Sparxx947/esphome-klingel/docs/verlauf.en.md

🇩🇪 [Deutsche Version](verlauf.md)

# Project history and decisions

| Date | Step | Result / decision |
|---|---|---|
| 04.10.2026 | Starting point | There was no doorbell entity in HA. First draft: **one** PC814 parallel to the chime via 1 kΩ 0.5 W on D5, event "Haustür" (front door); optional "chime mute" relay on D1 (normally closed, so the chime keeps ringing if the ESP fails). Compiled with ESPHome 2026.9.1: RAM 38.4 %, flash 40.2 %. |
| 04.10. evening | Jens: conventional system, **3 buttons**, no socket at the chime | 3 × PC814 on D5/D6/D7, one `event` each; power planned from the bell transformer (bridge rectifier + 1000 µF + step-down to 5.0 V). Recompiled: RAM 39.0 %, flash 40.3 %. |
| 04.10. late | Buttons = ground floor / floor 1 / floor 2; transformer in the stairwell distribution board | `substitutions` set; HA draft: 3 trigger templates for Alexa, automation `parallel`, lockout 15 s **per button** (tested). Two bugs of the first draft fixed (`not_from: unknown`, global lockout). Idea "everything at the transformer" with diode tap (2+2 anti-parallel 1N5408 in series with the return line, PC817/814 + ~47 Ω in parallel) – untested, since discarded. |
| 04.10. evening | paused | Jens: "remember it, we'll continue later". |
| 06.10. | Board inventory | Second D1 mini in stock → "D1 #2" for the doorbell, no new board needed. |
| 06.10. | Photos of distribution board | Plastic small distribution boards in a wooden recess (no metal → normal D1 mini). Transformer **Hager ST303, 8 VA**, 8 V (2–4) / 12 V (2–8). **Decision: do not power the D1 from the transformer** (8 VA for chime + ESP peaks ~350 mA too tight) → USB power supply at the distribution board socket. Next to it a Finder 14.01 (stair light, separate project). |
| 06.10. | Junction box | Jens: top left, **every** doorbell line runs through a junction box → tap point. Photos: doorbell wires only, the supposed paper is old masking-tape labelling. Assignment from photos not possible → measurement with multimeter. |
| 06.10. | Recipients | GF → residents ground floor, floor 1/2 → residents floors 1/2; wall panels for every floor. |
| 06.10. ~21:00 | Parts | PC814 not available on Amazon.de before 15.10. → **PC817C** + anti-parallel reverse diode (1N4007/1N5819 from the diode assortment). Series resistor 1 kΩ / 0.25 W. Perfboard: mini solder boards 45 × 39 mm. Both ordered by Jens. |
| 06.10. | Workshop book | Section K1 with schematic PC817 + 1N4007 (stripe to pin 1). |
| 07.10. | Delivery | PC817C and diode assortment arrived (confirmed by Jens on 08.10.). |
| 09.10. | Delivery | Mini solder boards arrived → parts complete (PC817C, diodes, boards). Wire measurement moved to Sat 10.10. |
| 10.10. (planned) | Measure wires | **Did not take place** – assignment of the wires in the junction box still open. |
| 11.10. | Firmware filter | Order corrected before the first flash: `delayed_off: 200ms` **first**, then `delayed_on: 230ms` (200 + 30 ms, because `delayed_off` also extends spikes by 200 ms). With PC817 + reverse diode the input at 50 Hz is ON for only ~10 ms per 20 ms – `delayed_on` first would have discarded every press. Header comments updated to PC817 + USB supply. |
| 11.10. | Colour schematic | Print sheet A4 landscape with wire colours: `plaene/klingel-schaltplan-farbig.pdf`. Doorbell side grey = chime return, yellow = ground floor, green = floor 1, blue = floor 2; ESP side yellow → D5, green → D6, blue → D7, black → G; no red (reserved for +5 V). |
| 11.10. | Enclosure | Designed in OpenSCAD (`gehaeuse/klingel-gehaeuse.scad`, parts `box`/`deckel`) and adapted to the measured dimensions (perfboard 44.12 × 38.74, D1 34.2 × 25.6, D1 height 25 mm, USB overmould 10.8 × 7.2, wires 4 × Ø 1.38). First version: openings ended blind because `hull()` with corner bosses on the outside thickened all walls to 6.5 mm → screw columns moved inside. Test print of an earlier version: perfboard fits. Printing of the current version not yet confirmed. |
| 11.10. | Board soldered | The mini solder board has **individual pads without tracks**. During the first soldering the connections reverse diode ↔ pin 1/pin 2, resistor ↔ pin 1 and pin 2 ↔ return conductor were therefore missing. After re-soldering, per channel (all 3 identical): diode test + on pin 1 → pin 2 = 1.08 V (LED), + on pin 2 → pin 1 = 0.60 V (1N4007); doorbell side ↔ ESP side no continuity. 1 kΩ resistors from stock fitted. |
| 11.10. | First flash | Locally via USB with the real secrets (ESPHome 2026.9.1): RAM 39.0 %, flash 40.3 %. Wi-Fi connected, API handshake with the real key ok. Created in the ESPHome Builder as `klingel.yaml`; Builder secrets, HA adoption and static IP open. |
| 11.10. | Bench test | An 18650 shield (power-bank board) as source gave **no** detection (presumably it does not switch its output on at ~8 mA load; not investigated further). With a bare 18650 cell (minus to grey, plus for 2–3 s to the colour) **passed**: blue → only "Etage 2", yellow → only "Erdgeschoss", green → only "Etage 1", several times each, event `gedrueckt` every time, no crosstalk. |
| 11.10. | Anomaly | In the `esphome logs` client the event `gedrueckt` arrived ~0.13–0.21 s **after** the OFF of the binary sensor each time, never at the ON (example: ON 44.26 s, OFF 49.84 s, event 50.05 s). Unexplained, check after HA adoption (see [troubleshooting no. 16](fehlersuche.en.md#16-event-appears-only-after-the-off)). |
| 11.10. | HA adoption | Builder secrets added, ESPHome integration adopted in HA (entities `event.klingel_erdgeschoss`/`_etage_1`/`_etage_2`, `binary_sensor.klingel_*_gedruckt`), static IP in the router. Event timing checked in HA: event 49.818 s before binary sensor ON 49.922 s (OFF 53.588 s) → the anomaly in the log client is **not a fault**. Enclosure printing. |
| 12.10. ~14:00 | Installation test PC817 | Board connected at the junction box (grey wire on the 5-way WAGO), chime rings normally. Practically nothing is detected: only sporadic hits (floor 1 and ground floor once each, floor 2 never), no permanent ON. Jens: the chime is a **battery chime**. The assumption "the transformer drives the chime" had **never been verified** until then. |
| 12.10. ~14:30–15:00 | Wrong measurement | First measurement series in the box: 0 V at rest, ~0.3 V when pressed; −0.6 V at rest. Conclusions were drawn from this ("reverse diode clamps the sensing circuit", then "0.6 V = sensing voltage of the chime"). **All these values were measured on DC**, AC was intended – meaningless on AC voltage. It only showed up in a cross-check **at a known reference**: transformer terminals 2–4 on AC = 8 V ✔. The conclusions drawn until then are void. Lesson: [einmessen.en.md 0](einmessen.en.md#0-check-meter-range-and-the-device-at-the-other-end-first), [fehlersuche.en.md no. 19](fehlersuche.en.md#19-readings-make-no-sense). |
| 12.10. ~15:00–16:35 | AC measurements, reconnecting | On AC: 5-way WAGO ↔ floor 1 wire 6.33 V at rest, 6.9 V when pressed (multimeter high-impedance); across the 1 kΩ 0 V when pressed → no current through the board. Grey wire successively on the 5-way WAGO, transformer terminals 2, 4 and 8 – several presses each, **0 hits**; the only hits were connection transients (several channels at once). Jens: the 5-way WAGO is transformer pole 4 (all button wires meet there) – so the WAGO and terminal-4 tests were the same. Against the WAGO the wire **rose** when pressed (7.7 → 8.3 V) instead of dropping to ~0 → the measured wire is not the one switched by the button. |
| 12.10. ~16:45 | **Cause found** | Photo of the floor 1 chime: electronic chime with a **9 V block battery**, loudspeaker, board, only 2 wires. DC at the chime terminals at rest **9 V**. → Each floor has its **own battery chime with a contact input**; the button only shorts the chime loop, the transformer is **not** in the chime circuit. The optocoupler therefore never gets current – that explains all failed attempts. Ground floor probably also 9 V (*unverified*), floor 2 a different chime with 3 × C cell = 4.5 V. Buttons without illumination. What the transformer is still used for is *unclear*. Grey wire disconnected, chimes work normally. |
| 12.10. ~17:05 | Plan 2N7000 | Print sheet `plaene/klingel-schaltplan-mosfet.pdf`: per floor plus wire → 1 MΩ → gate 2N7000, drain → D5/D6/D7 (internal pull-up), source + minus wires + G common; rest = LOW, press = HIGH. **Assumption (unmeasured):** separate plus wire per floor, minus sides can be joined. If floor 2 is below ~3.5 V, BC547 instead of 2N7000. |
| 12.10. ~17:15–17:40 | Parts | No MOSFETs/transistors in stock, but 1 MΩ available. Considered: a bag of 100 × 2N7000 and a resistor assortment; ordered instead: a **transistor set with 24 types** (contains 2N7000 and BC547 as fallback for floor 2), delivery 14.10. |
| 12.10. | Side finding | During the installation test an event arrived in HA, but `binary_sensor.klingel_*_gedruckt` never showed "on". **Unexplained.** |
| 13.10. | Cross-check and docs | Firmware local = ESPHome Builder (checked) = `firmware/klingel.yaml` in the repo (except the deliberately removed MAC address). **Firmware not yet switched to 2N7000.** Repo updated: status, MOSFET plan and measuring sheet in `plaene/`, measurement lesson in einmessen/fehlersuche. Open: measure polarity per floor, rebuild from 14.10. |
| 14.10. | DC measurement | Only DC at the chime; when ringing it drops to **0 V** at the chime → contact input confirmed (the button shorts the battery loop). Per floor: terminal 1 = chime wire, terminal 2 = return. Floor 1 ~9.5 V, ground floor **2 × AA ≈ 3 V** (2.7 V in the box), floor 2 initially without batteries (silent, fitted with 3 × C cells on 15.10.). |
| 14.10. | 2N7000 dropped | For the ground floor with ~3 V the 2N7000 gate threshold is too marginal → **BC517** (Darlington) ordered, base resistor 10 MΩ. |
| 16.10. | New board layout | Working area 13 × 13 holes centred on the mini board (enclosure still fits), TO-92 rotated. Two variants from one script: 3 × BC517 + 10 MΩ and a substitute 3 × (2 × BC547 as Darlington) + 1 MΩ in case the delivery fails (`plaene/klingel_darlington_layout.py`). |
| 17.10. | Delivery delay | 10 MΩ sold out → switched to **9.1 MΩ**; fits without layout change (calculated: ground floor ~0.2 µA base current, loop stays at ~2.8 V). |
| 20.10. | Delivery + rebuild | BC517 and 9.1 MΩ arrived, plan changed to 9.1 MΩ (colour bands white–brown–blue). Board rebuilt and connected. |
| 20.10. ~15:15 | First test ✗ | All three channels HIGH at idle, no event for 9 presses (with the old, inverted firmware "idle LOW" would have shown as permanently "pressed"). Once the ground-floor chime rang an extra time (unexplained). |
| 20.10. ~15:30–15:55 | Troubleshooting | Measuring sheet (`plaene/klingel-messblatt-bc517.pdf`): reference 3V3↔G = +3.3 V; Kl.1 against grey **+3.1 / +9.47 / +5.5 V** (polarity correct). "G against wire" however gave −2 / −2 / −4 V – this was wrongly taken as a missing GND connection; the continuity check (`plaene/klingel-durchgang-bc517.pdf`) showed all GND connections fine. Where the −2/−4 V came from is **unexplained**. |
| 20.10. 16:03 | Working | After a further fix on the board (details not recorded) all three channels are correct at idle (LOW); test presses on floors 1/2 detected. |
| 20.10. 16:13 | Firmware BC517 | Via OTA from the ESPHome Builder: `inverted: false`, `delayed_on: 30ms` / `delayed_off: 100ms`, new sensor "Klingelbatterie leer" (one channel pressed > 30 s). |
| 20.10. 16:17 | **Acceptance passed** | Ground floor, floor 1, floor 2 in turn → exactly one event each (pressed 0.31 / 0.37 / 0.34 s), no crosstalk. The event arrives ~0.1 s before the binary sensor – the side finding of 12.10. is resolved. |
| 20.10. ~15:15 | No crosstalk | An extra ring on the ground floor right after the first test presses was a real visitor at the front door. |
| 20.10. 17:03 | **HA integration accepted** | Push with camera image to the phone; ground floor and floor 1 show the live image on their wall panel for 90 s and return to the start page ([home-assistant.en.md](home-assistant.en.md)). |

## Discarded variants

| Variant | Reason |
|---|---|
| Power from the bell transformer (rectifier, electrolytic capacitor, step-down) | Hager ST303 has only 8 VA; socket available in the distribution board |
| Tap directly at the transformer via diodes in the return line | junction box offers all floors in one place, without intervening in the distribution board |
| DIN-rail enclosure in the distribution board | tap no longer in the distribution board |
| D1 mini Pro with external antenna | no metal cabinet; only if RSSI at the installation site is poor |
| PC814 | not available at short notice |
| Powering the bench test via an 18650 shield (power-bank board) | no detection (load cut-off suspected) → bare cell or lab power supply |
| Bench test with 5 V from the D1 mini (suggestion from `einmessen.md`) | G on the D1 is occupied, isolation doorbell/ESP side would not be preserved → separate battery |
| **Optocoupler tap (PC817 + 1N4007 + 1 kΩ)** | 12.10.: the chimes are battery chimes with a contact input, the transformer is not in the chime circuit → the LED never gets current. Replacement: BC517 + 9.1 MΩ (since 20.10.) |
| 2N7000 + 1 MΩ | 14.10.: ground-floor loop only ~3 V, gate threshold too marginal → BC517 |
| ESP between button and chime (trigger the chime via PC817) or ESP32 ADC with bias divider | briefly considered on 12.10. – based on the wrong DC measurement, therefore void |
