Sparxx947/esphome-klingel/docs/verlauf.md

🇬🇧 [English version](verlauf.en.md)

# Projektverlauf und Entscheidungen

| Datum | Schritt | Ergebnis / Entscheidung |
|---|---|---|
| 04.10.2026 | Ausgangslage | In HA gab es keine Klingel-Entität. Erster Entwurf: **ein** PC814 parallel zum Gong über 1 kΩ 0,5 W an D5, Event „Haustür“; optional Relais „Gong stumm“ an D1 (Öffner, damit der Gong bei ESP-Ausfall weiter klingelt). Kompiliert mit ESPHome 2026.9.1: RAM 38,4 %, Flash 40,2 %. |
| 04.10. abends | Jens: klassische Anlage, **3 Taster**, keine Steckdose am Gong | 3 × PC814 an D5/D6/D7, je ein `event`; Versorgung aus dem Klingeltrafo geplant (Brückengleichrichter + 1000 µF + Step-down auf 5,0 V). Neu kompiliert: RAM 39,0 %, Flash 40,3 %. |
| 04.10. spät | Taster = Erdgeschoss / Etage 1 / Etage 2; Trafo im Verteiler Treppenhaus | `substitutions` gesetzt; HA-Entwurf: 3 Trigger-Templates für Alexa, Automation `parallel`, Sperre 15 s **je Taster** (getestet). Zwei Fehler des ersten Entwurfs behoben (`not_from: unknown`, globale Sperre). Idee „alles am Trafo“ mit Dioden-Abgriff (2+2 antiparallele 1N5408 in Reihe zur Rückleitung, PC817/814 + ~47 Ω parallel) – ungetestet, inzwischen verworfen. |
| 04.10. abends | pausiert | Jens: „merken, machen wir später weiter“. |
| 06.10. | Board-Inventur | Zweiter D1 mini im Bestand → „D1 #2“ für die Klingel, kein neues Board nötig. |
| 06.10. | Fotos Verteiler | Kunststoff-Kleinverteiler in Holznische (kein Metall → normaler D1 mini). Trafo **Hager ST303, 8 VA**, 8 V (2–4) / 12 V (2–8). **Entscheidung: D1 nicht aus dem Trafo versorgen** (8 VA für Gong + ESP-Spitzen ~350 mA zu knapp) → USB-Netzteil an der Verteiler-Steckdose. Daneben Finder 14.01 (Treppenlicht, eigenes Projekt). |
| 06.10. | Abzweigdose | Jens: oben links läuft **jede** Klingelleitung durch eine Abzweigdose → Abgriffpunkt. Fotos: nur Klingeladern, das vermeintliche Papier ist alte Kreppband-Beschriftung. Zuordnung aus Fotos nicht möglich → Messung mit Multimeter. |
| 06.10. | Empfänger | EG → Bewohner EG, Etage 1/2 → Bewohner Etage 1/2; Wandpanels bei jeder Etage. |
| 06.10. ~21:00 | Teile | PC814 bei Amazon.de nicht vor 15.10. lieferbar → **PC817C** + antiparallele Gegendiode (1N4007/1N5819 aus dem Diodensortiment). Vorwiderstand 1 kΩ / 0,25 W. Lochraster: Minilötplatinen 45 × 39 mm. Beides von Jens bestellt. |
| 06.10. | Werkstattbuch | Abschnitt K1 mit Schaltplan PC817 + 1N4007 (Strich an Pin 1). |
| 07.10. | Lieferung | PC817C und Diodensortiment da (von Jens am 08.10. bestätigt). |
| 09.10. | Lieferung | Minilötplatinen da → Teile komplett (PC817C, Dioden, Platinen). Adern-Messung auf Sa 10.10. verschoben. |
| 10.10. (geplant) | Adern messen | **Hat nicht stattgefunden** – Zuordnung der Adern in der Abzweigdose weiter offen. |
| 11.10. | Firmware-Filter | Reihenfolge vor dem Erstflash korrigiert: `delayed_off: 200ms` **zuerst**, dann `delayed_on: 230ms` (200 + 30 ms, weil `delayed_off` auch Störspitzen um 200 ms verlängert). Mit PC817 + Gegendiode ist der Eingang bei 50 Hz nur ~10 ms je 20 ms EIN – `delayed_on` zuerst hätte jeden Druck verworfen. Kopfkommentare auf PC817 + USB-Versorgung aktualisiert. |
| 11.10. | Schaltplan farbig | Druckblatt A4 quer mit Litzenfarben: `plaene/klingel-schaltplan-farbig.pdf`. Klingelseite grau = Gong-Rückleiter, gelb = Erdgeschoss, grün = Etage 1, blau = Etage 2; ESP-Seite gelb → D5, grün → D6, blau → D7, schwarz → G; kein Rot (bleibt für +5 V). |
| 11.10. | Gehäuse | In OpenSCAD konstruiert (`gehaeuse/klingel-gehaeuse.scad`, Teile `box`/`deckel`) und auf die gemessenen Maße angepasst (Lochraster 44,12 × 38,74, D1 34,2 × 25,6, Bauhöhe D1 25 mm, USB-Umspritzung 10,8 × 7,2, Litzen 4 × Ø 1,38). Erste Fassung: Durchbrüche endeten blind, weil `hull()` mit außen liegenden Eckdomen alle Wände auf 6,5 mm verdickte → Schraubsäulen nach innen. Testdruck einer früheren Fassung: Lochraster passt. Druck der aktuellen Fassung noch nicht bestätigt. |
| 11.10. | Platine gelötet | Die Minilötplatine hat **einzelne Lötpunkte ohne Leiterbahnen**. Beim ersten Löten fehlten deshalb die Verbindungen Gegendiode ↔ Pin 1/Pin 2, Widerstand ↔ Pin 1 und Pin 2 ↔ Rückleiter. Nach dem Nachlöten je Kanal (alle 3 gleich): Diodentest + an Pin 1 → Pin 2 = 1,08 V (LED), + an Pin 2 → Pin 1 = 0,60 V (1N4007); Klingelseite ↔ ESP-Seite kein Durchgang. 1 kΩ-Widerstände aus dem Bestand verbaut. |
| 11.10. | Erstflash | Per USB lokal mit echten Secrets (ESPHome 2026.9.1): RAM 39,0 %, Flash 40,3 %. WLAN verbunden, API-Handshake mit echtem Schlüssel ok. Im ESPHome Builder als `klingel.yaml` angelegt; Builder-Secrets, HA-Adoption und feste IP offen. |
| 11.10. | Tischtest | Ein 18650-Shield (Powerbank-Platine) als Quelle lieferte **keine** Erkennung (vermutlich schaltet es bei ~8 mA Last den Ausgang nicht ein, nicht weiter untersucht). Mit einer nackten 18650-Zelle (Minus an grau, Plus 2–3 s an die Farbe) **bestanden**: blau → nur „Etage 2“, gelb → nur „Erdgeschoss“, grün → nur „Etage 1“, je mehrfach, jedes Mal Event `gedrueckt`, kein Übersprechen. |
| 11.10. | Auffälligkeit | Im `esphome logs`-Client kam das Event `gedrueckt` jeweils ~0,13–0,21 s **nach** dem OFF des Binärsensors an, nie beim ON (Beispiel: ON 44,26 s, OFF 49,84 s, Event 50,05 s). Ungeklärt, nach der HA-Adoption prüfen (siehe [Fehlersuche Nr. 16](fehlersuche.md#16-event-erscheint-erst-nach-dem-off)). |
| 11.10. | HA-Adoption | Builder-Secrets eingetragen, ESPHome-Integration in HA eingebunden (Entitäten `event.klingel_erdgeschoss`/`_etage_1`/`_etage_2`, `binary_sensor.klingel_*_gedruckt`), feste IP im Router. Event-Zeitpunkt in HA geprüft: Event 49,818 s vor Binärsensor-EIN 49,922 s (AUS 53,588 s) → die Auffälligkeit im Log-Client ist **kein Fehler**. Gehäuse im Druck. |
| 12.10. ~14:00 | Einbautest PC817 | Platine an der Abzweigdose angeschlossen (graue Litze an die 5er-WAGO), Gong läutet normal. Erkannt wird praktisch nichts: nur sporadische Treffer (Etage 1 und Erdgeschoss je einmal, Etage 2 nie), kein Dauer-EIN. Jens: der Gong ist ein **Batteriegong**. Die Annahme „der Trafo treibt den Gong“ war bis dahin **nie geprüft** worden. |
| 12.10. ~14:30–15:00 | Fehlmessung | Erste Messreihe in der Dose: Ruhe 0 V, beim Drücken ~0,3 V; in Ruhe −0,6 V. Daraus zunächst Schlüsse gezogen („Gegendiode klemmt den Abfragekreis“, dann „0,6 V = Abfragespannung des Gongs“). **Alle diese Werte waren auf DC gemessen**, gemeint war AC – an Wechselspannung bedeutungslos. Aufgefallen ist es erst beim Gegencheck **am bekannten Anker**: Trafo Klemme 2–4 auf AC = 8 V ✔. Die bis dahin gezogenen Schlüsse sind damit hinfällig. Lehre: [einmessen.md 0](einmessen.md#0-messbereich-und-gerät-am-anderen-ende-zuerst-prüfen), [fehlersuche.md Nr. 19](fehlersuche.md#19-messwerte-ergeben-keinen-sinn). |
| 12.10. ~15:00–16:35 | AC-Messungen, Umklemmen | Auf AC: 5er-WAGO ↔ Ader Etage 1 in Ruhe 6,33 V, beim Drücken 6,9 V (Multimeter hochohmig); über dem 1 kΩ beim Drücken 0 V → kein Strom durch die Platine. Graue Litze nacheinander an 5er-WAGO, Trafo-Klemme 2, 4 und 8 – je mehrere Drücke, **0 Treffer**; die einzigen Treffer waren Anklemmstöße (mehrere Kanäle gleichzeitig). Jens: die 5er-WAGO ist Trafo-Pol 4 (alle Taster-Leitungen laufen dort zusammen) – WAGO- und Klemme-4-Test waren also derselbe. Gegen die WAGO **stieg** die Ader beim Drücken (7,7 → 8,3 V) statt auf ~0 zu fallen → die gemessene Ader ist nicht die vom Taster geschaltete. |
| 12.10. ~16:45 | **Ursache gefunden** | Foto des Gongs Etage 1: elektronischer Gong mit **9-V-Block**, Lautsprecher, Platine, nur 2 Drähte. DC an den Gong-Klemmen in Ruhe **9 V**. → Jede Etage hat einen **eigenen Batteriegong mit Kontakteingang**; der Taster schließt nur die Gong-Schleife kurz, der Trafo ist **nicht** im Gong-Kreis. Der Optokoppler bekommt deshalb nie Strom – das erklärt alle Fehlversuche. Erdgeschoss vermutlich auch 9 V (*ungeprüft*), Etage 2 ein anderer Gong mit 3 × Babyzelle = 4,5 V. Taster ohne Beleuchtung. Wozu der Trafo noch dient, ist *ungeklärt*. Graue Litze abgeklemmt, Gongs laufen normal. |
| 12.10. ~17:05 | Plan 2N7000 | Druckblatt `plaene/klingel-schaltplan-mosfet.pdf`: je Etage Plus-Ader → 1 MΩ → Gate 2N7000, Drain → D5/D6/D7 (interner Pull-up), Source + Minus-Adern + G gemeinsam; Ruhe = LOW, Druck = HIGH. **Annahme (ungemessen):** je Etage eigene Plus-Ader, Minus-Seiten verbindbar. Liegt Etage 2 unter ~3,5 V, BC547 statt 2N7000. |
| 12.10. ~17:15–17:40 | Teile | Keine MOSFETs/Transistoren im Bestand, 1 MΩ aber vorhanden. Erwogen: 2N7000 im 100er-Beutel und ein Widerstandssortiment; bestellt wurde stattdessen ein **Transistor-Set mit 24 Typen** (enthält 2N7000 und BC547 als Ausweichlösung für Etage 2), Lieferung 14.10. |
| 12.10. | Nebenbefund | Beim Einbautest kam ein Event in HA an, `binary_sensor.klingel_*_gedruckt` zeigte dabei nie „on“. **Ungeklärt.** |
| 13.10. | Abgleich und Doku | Firmware lokal = ESPHome Builder (geprüft) = `firmware/klingel.yaml` im Repo (bis auf die bewusst entfernte MAC-Adresse). **Firmware noch nicht auf 2N7000 umgestellt.** Repo nachgezogen: Status, MOSFET-Plan und Messblatt in `plaene/`, Mess-Lehre in einmessen/fehlersuche. Offen: Polarität je Etage messen, Umbau ab 14.10. |
| 14.10. | DC-Messung | Am Gong nur Gleichspannung; beim Klingeln fällt sie am Gong auf **0 V** → Kontakteingang bestätigt (Taster schließt die Batterie-Schleife kurz). Je Etage: Klemme 1 = Gong-Ader, Klemme 2 = Rückkanal. Etage 1 ~9,5 V, Erdgeschoss **2 × AA ≈ 3 V** (2,7 V in der Dose), Etage 2 zunächst ohne Batterien (stumm, am 15.10. mit 3 × Babyzelle bestückt). |
| 14.10. | 2N7000 verworfen | Für das Erdgeschoss mit ~3 V ist die Gate-Schwelle des 2N7000 zu knapp → **BC517** (Darlington) bestellt, Basiswiderstand 10 MΩ. |
| 16.10. | Neues Platinenlayout | Arbeitsfeld 13 × 13 Löcher mittig auf der Minilötplatine (Gehäuse passt weiter), TO-92 gedreht. Zwei Varianten aus einem Skript: 3 × BC517 + 10 MΩ und Ersatz 3 × (2 × BC547 als Darlington) + 1 MΩ für den Fall, dass die Lieferung ausbleibt (`plaene/klingel_darlington_layout.py`). |
| 17.10. | Lieferverzug | 10 MΩ ausverkauft → Tausch auf **9,1 MΩ**; passt ohne Layoutänderung (gerechnet: Erdgeschoss ~0,2 µA Basisstrom, Schleife bleibt bei ~2,8 V). |
| 20.10. | Lieferung + Umbau | BC517 und 9,1 MΩ da, Plan auf 9,1 MΩ umgestellt (Farbringe weiß–braun–blau). Platine umgebaut und angeschlossen. |
| 20.10. ~15:15 | Erster Test ✗ | Alle drei Kanäle in Ruhe HIGH, kein Event bei 9 Drücken (mit noch alter, invertierter Firmware wäre „Ruhe LOW“ als Dauer-„gedrückt“ sichtbar gewesen). Einmal läutete der Erdgeschoss-Gong zusätzlich (ungeklärt). |
| 20.10. ~15:30–15:55 | Fehlersuche | Messblatt (`plaene/klingel-messblatt-bc517.pdf`): Kontrollmessung 3V3↔G = +3,3 V; Kl.1 gegen grau **+3,1 / +9,47 / +5,5 V** (Polarität richtig). Messung „G gegen Ader“ ergab dagegen −2 / −2 / −4 V – daraus wurde fälschlich auf eine fehlende GND-Verbindung geschlossen; die Durchgangsprüfung (`plaene/klingel-durchgang-bc517.pdf`) zeigte alle GND-Verbindungen in Ordnung. Wie die −2/−4 V zustande kamen, ist **ungeklärt**. |
| 20.10. 16:03 | Läuft | Nach einem weiteren Eingriff an der Platine (nicht im Einzelnen festgehalten) stehen alle drei Kanäle in Ruhe richtig (LOW); Testdrücke Etage 1/2 erkannt. |
| 20.10. 16:13 | Firmware BC517 | Per OTA aus dem ESPHome Builder: `inverted: false`, `delayed_on: 30ms` / `delayed_off: 100ms`, neuer Sensor „Klingelbatterie leer“ (ein Kanal > 30 s gedrückt). |
| 20.10. 16:17 | **Abnahme bestanden** | Erdgeschoss, Etage 1, Etage 2 nacheinander → je genau ein Event (gedrückt 0,31 / 0,37 / 0,34 s), kein Übersprechen. Event kommt ~0,1 s vor dem Binärsensor – der Nebenbefund vom 12.10. ist damit erledigt. |
| 20.10. ~15:15 | Kein Übersprechen | Ein zusätzliches Klingeln im EG direkt nach den ersten Testdrücken war ein echter Besucher an der Haustür. |
| 20.10. 17:03 | **HA-Anbindung abgenommen** | Push mit Kamerabild aufs Handy; EG und Etage 1 zeigen auf ihrem Wandpanel 90 s das Livebild und kehren zur Startseite zurück ([home-assistant.md](home-assistant.md)). |

## Verworfene Varianten

| Variante | Grund |
|---|---|
| Versorgung aus dem Klingeltrafo (Gleichrichter, Elko, Step-down) | Hager ST303 hat nur 8 VA; Steckdose im Verteiler vorhanden |
| Abgriff direkt am Trafo über Dioden in der Rückleitung | Abzweigdose bietet alle Etagen an einer Stelle, ohne Eingriff in den Verteiler |
| Hutschienengehäuse im Verteiler | Abgriff nicht mehr im Verteiler |
| D1 mini Pro mit Außenantenne | kein Metallkasten; nur falls RSSI am Einbauort schlecht |
| PC814 | nicht kurzfristig lieferbar |
| Versorgung des Tischtests über 18650-Shield (Powerbank-Platine) | keine Erkennung (Lastabschaltung vermutet) → nackte Zelle oder Labornetzteil |
| Tischtest mit 5 V vom D1 mini (Vorschlag aus `einmessen.md`) | G am D1 ist belegt, die Trennung Klingel-/ESP-Seite bliebe nicht erhalten → separate Batterie |
| **Optokoppler-Abgriff (PC817 + 1N4007 + 1 kΩ)** | 12.10.: die Gongs sind Batteriegongs mit Kontakteingang, der Trafo ist nicht im Gong-Kreis → die LED bekommt nie Strom. Ersatz: BC517 + 9,1 MΩ (seit 20.10.) |
| 2N7000 + 1 MΩ | 14.10.: Erdgeschoss-Schleife nur ~3 V, Gate-Schwelle zu knapp → BC517 |
| ESP zwischen Taster und Gong (Gong über PC817 auslösen) bzw. ESP32-ADC mit Vorspannungsteiler | am 12.10. kurz erwogen – auf Grundlage der DC-Fehlmessung, damit hinfällig |
