Sparxx947/esphome-klingel/docs/einmessen.md

🇬🇧 [English version](einmessen.en.md)

# Einmessen / Kalibrieren

Eine Klingel hat keine Messwerte im engeren Sinn. „Einmessen“ heißt hier: herausfinden, **welche Ader zu welcher Etage**
gehört, die **Gong-Spannung** bestimmen, die Bauteilwerte dagegen nachrechnen, Bauteile und Platine **vor** dem Einbau
prüfen und nach dem Einbau Filter und WLAN kontrollieren.

> **Stand 20.10.2026:** Die Abschnitte 2–6 beziehen sich auf die historische PC817-Variante. Für die BC517-Schaltung
> gelten Abschnitt 0 (Messbereich, Gerät am anderen Ende) und das Messblatt
> [`plaene/klingel-messblatt-bc517.pdf`](../plaene/klingel-messblatt-bc517.pdf).

Werte aus den Projektnotizen sind belegt; mit *(Vorschlag)* oder *(ungeprüft)* markierte Schritte stehen so nicht in den
Notizen bzw. wurden noch nicht am Gerät nachvollzogen.

---

## 0. Messbereich und Gerät am anderen Ende zuerst prüfen

**Lehre aus dem Einbautest am 12.10.2026.** Rund zwei Stunden lang wurden aus Messwerten Schlüsse gezogen, die auf zwei
ungeprüften Grundlagen standen:

1. Das Multimeter stand auf **DC**, gemessen werden sollte Wechselspannung. Ein Wert von **−0,6 V „auf V~“** hätte
   sofort auffallen müssen: Eine AC-Anzeige hat **kein Vorzeichen**.
2. Der ganze Abgriff setzte voraus, dass der **Trafo den Gong treibt**. Dass jede Etage einen **Batteriegong mit
   Kontakteingang** hat, zeigte erst ein Foto des Gongs. Die Annahme „klassische Anlage“ war nie gemessen worden.

Deshalb jetzt vor jeder Messreihe:

| Schritt | Wie | Warum |
|---|---|---|
| Messbereich am **bekannten Anker** prüfen | z. B. Trafo Klemme 2–4 auf V~ → muss ~8 V zeigen; für DC eine Batterie mit bekannter Spannung | ein Messwert ohne gesicherten Bereich ist keine Messung |
| Negativer Wert bei „AC“ | sofort den Bereich anzweifeln | AC-Anzeigen sind vorzeichenlos – ein Minus bedeutet DC-Bereich |
| **Gerät am anderen Ende ansehen**, bevor ein Abgriff entworfen wird | Foto des Gongs/Verbrauchers, Typenschild, Batteriefach, Zahl der Drähte | die Bauart (Trafo-Gong oder Batteriegong mit Kontakteingang) entscheidet über die ganze Schaltung |
| Treffer nur direkt nach dem Anklemmen, mehrere Kanäle gleichzeitig | als **Anklemmstoß** werten, nicht als Tastendruck | ein echter Druck betrifft genau eine Etage |

**Für den Umbau auf 2N7000** heißt das konkret (Messung noch offen):

1. Multimeter auf **V⎓** (DC), Bereich an einer Batterie mit bekannter Spannung prüfen.
2. In der Abzweigdose je Etage die **zwei Adern mit Gong-Spannung** suchen (Etage 1: ~9 V in Ruhe; Etage 2 erwartet
   ~4,5 V, *ungemessen*).
3. Schwarze Spitze an Ader A, rote an Ader B: **+** Wert → B ist Plus (Signal), A ist Minus; **−** Wert → umgekehrt.
4. Prüfen, ob die Minus-Seiten der drei Etagen verbunden werden dürfen (der Plan setzt das voraus). Nie zwei
   Plus-Adern verbinden und nie Plus mit Minus – das löst den Gong aus.
5. Ruhespannung je Etage notieren: unter ~3,5 V reicht der 2N7000 nicht sicher → BC547 vorgesehen.

| Etage | Ader Plus | Ader Minus | Ruhespannung V⎓ | beim Drücken |
|---|---|---|---|---|
| Erdgeschoss | … | … | … V | … V |
| Etage 1 | … | … | ~9 V (an den Gong-Klemmen gemessen) | … V |
| Etage 2 | … | … | … V | … V |

---

## 1. Adern zuordnen

> **Überholt (12.10.):** Die folgende Anleitung geht davon aus, dass der Trafo den Gong treibt (V~-Messung gegen die
> 5er-WAGO). Das trifft hier nicht zu – die Gongs sind Batteriegongs. Messergebnisse 12.10. siehe
> [verlauf.md](verlauf.md); für den Umbau gilt Abschnitt 0. Der Text bleibt zur Nachvollziehbarkeit stehen.

**Termin: offen.** Geplant waren Fr 09.10. und Sa 10.10. – die Messung hat noch nicht stattgefunden (Stand 11.10.).
Für die Litzen zur Platine sind die Farben schon festgelegt: grau = Gong-Rückleiter, gelb = Erdgeschoss,
grün = Etage 1, blau = Etage 2.

Ausgangslage (Fotos 06.10.): In der Abzweigdose oben links über dem linken Verteiler laufen mehrere Fernmeldeleitungen
zusammen (Adern rot, schwarz, gelb, weiß, blau, lila, grün, grau, schwarz-weiß und schwarz-orange geringelt). Unten
kommen Einzeladern rot/weiß/blau heraus – vermutlich zum Trafo im Verteiler. Verbunden ist mit Lüsterklemmen sowie einer
WAGO 2273-203 (3-fach) und einer **WAGO 2273-205 (5-fach)**, die vermutlich den gemeinsamen Leiter vom Trafo trägt.
Die alten Kreppband-Beschriftungen sind kaum lesbar. Aus den Fotos war die Zuordnung **nicht** möglich.

### Vorgehen

1. Abdeckung der Dose öffnen. Werden Klemmen gelöst: **vorher Sicherung des Klingeltrafos aus.** Zum Messen selbst
   muss die Anlage natürlich unter Spannung stehen (Kleinspannung 8/12 V AC).
2. Multimeter auf **V~** (Wechselspannung, Bereich 20 V oder Auto).
3. Eine Messspitze fest an die **5er-WAGO** (gemeinsamer Leiter).
4. Zweite Person drückt unten **einen** Klingelknopf und hält ihn; mit der anderen Spitze nacheinander die
   Lüsterklemmen-Schrauben abtasten.
5. Die Ader, die **nur bei diesem Knopf 8–12 V** zeigt, ist die Etagenader dieser Etage.
6. Für die anderen beiden Knöpfe wiederholen.
7. Den **Gong-Rückleiter** (Gegenpol für Pin 2 der Optokoppler) bestimmen – laut Plan „per Messung bestimmen“.
   *(Ungeprüft, wie genau er sich in dieser Dose zeigt: Ist die 5er-WAGO selbst der Rückleiter, ist sie der
   gemeinsame Anschlusspunkt aller drei Pin 2.)*
8. Ergebnis notieren und **auf neues Kreppband schreiben**:

| Etage | Aderfarbe / Klemme | gemessene Spannung | Eingang |
|---|---|---|---|
| Erdgeschoss | … | … V~ | D5 |
| Etage 1 | … | … V~ | D6 |
| Etage 2 | … | … V~ | D7 |
| Rückleiter | … | – | Pin 2 aller PC817 |

Gegenprobe: Kreppband-Beschriftung lesen, falls möglich.

---

## 2. Gong-Spannung bestimmen

> **Entfällt (12.10.):** Die Gongs hängen nicht am Trafo. Abschnitt 2 und 3 gelten nur für die PC817-Variante.

Der Hager ST303 liefert **8 V zwischen Klemme 2–4** und **12 V zwischen 2–8**. Welche der Gong nutzt, ist offen.
Die Messung aus Schritt 1 zeigt es direkt (~8 V oder ~12 V effektiv; leerlaufend kann sie etwas höher liegen).

---

## 3. Bauteilwerte nachrechnen

### Spitzenspannung

Û = U_eff × √2

| Trafo-Abgriff | U_eff | Û |
|---|---|---|
| 8 V (2–4) | 8 V | ≈ 11,3 V |
| 12 V (2–8) | 12 V | ≈ 17 V |

Die LED des PC817 verträgt in Sperrrichtung nur ~6 V → **Gegendiode 1N4007 antiparallel ist Pflicht**.

### LED-Strom und Leistung am Vorwiderstand (1 kΩ)

Formel aus dem Werkstattbuch (U_F der LED ≈ 1,2 V):

I ≈ (U − 1,2 V) / 1 kΩ  P ≈ (U − 1,2 V)² / 1 kΩ

| Gong-Spannung | I (Effektivwert-Rechnung) | I in der Spitze (Û) | P am Widerstand |
|---|---|---|---|
| 8 V | ≈ 6,8 mA | ≈ 10 mA | ≈ 0,05 W |
| 12 V | ≈ 11 mA | ≈ 16 mA | ≈ 0,12 W |

Die Rechnung mit dem Effektivwert ist konservativ: Durch die Gegendiode leitet die LED nur in einer Halbwelle, die
tatsächliche Verlustleistung ist etwa halb so groß. **1 kΩ / 0,25 W reicht** in beiden Fällen. Der Optokoppler verträgt
laut Notizen 50 mA (dort für den PC814 genannt; beim PC817 laut gängigem Datenblatt ebenfalls 50 mA – *nicht gegen das
konkrete Datenblatt geprüft*).

### Belastung des Klingeltrafos

8 VA ⇒ max. ~1 A bei 8 V bzw. ~0,67 A bei 12 V. Die drei Optokoppler-Zweige ziehen nur je ~10 mA, und nur solange
geklingelt wird – unkritisch. Der D1 mini (~80 mA, Sendespitzen ~350 mA bei 5 V) wird **bewusst nicht** aus dem Trafo
versorgt.

---

## 4. Bauteile vor dem Löten prüfen

| Prüfung | Wie | Erwartung |
|---|---|---|
| 1N4007 Polung | Multimeter Diodentest | Durchlass ~0,6–0,7 V von Anode nach Kathode (Strich), Gegenrichtung „OL“ |
| PC817 LED | Diodentest zwischen Pin 1 (+) und Pin 2 | ~1,0–1,2 V Durchlass, umgekehrt „OL“ |
| PC817 Pin 1 finden | Punkt/Kerbe auf dem Gehäuse | Pin 1 = Anode, Pin 2 = Kathode, Pin 3 = Emitter, Pin 4 = Kollektor |
| Widerstand | Ohm-Messung | ~1 kΩ (Farbringe braun-schwarz-rot) |
| Gegendiode richtig herum | nach dem Löten Diodentest über Pin 1/Pin 2 | in **einer** Richtung ~0,65 V (1N4007, von Pin 2 nach Pin 1), in der anderen ~1,1 V (LED). Zeigen beide Richtungen ~0,65 V oder eine „OL“, ist etwas falsch |

*(Die Tabelle ist ein Vorschlag aus dem Schaltplan abgeleitet; Werte sind typische Datenblattwerte.)*

**Gemessen am 11.10.** nach dem Löten, alle 3 Kanäle gleich: + an Pin 1 → Pin 2 = **1,08 V** (LED), + an Pin 2 → Pin 1 =
**0,60 V** (1N4007); Klingelseite ↔ ESP-Seite **kein Durchgang**. Zeigt ein Kanal „OL“, fehlt auf der Einzelpad-Platine
vermutlich eine Verbindung (siehe [einbau.md A](einbau.md#a-platine-aufbauen)).

---

## 5. Tischtest vor dem Einbau

Ohne Klingeltrafo lässt sich jeder Kanal mit Gleichspannung testen.

### Tatsächlich verwendeter Weg (11.10., bestanden)

Quelle ist eine **separate Batterie** statt der 5 V vom D1 mini: G am D1 ist belegt, und so bleibt die Trennung zwischen
Klingel- und ESP-Seite auch beim Test erhalten.

1. D1 mini per USB versorgen, Firmware geflasht, Log offen (`esphome logs`).
2. Quelle: eine **nackte 18650-Zelle**. **Minus** an die graue Litze (Gong-Rückleiter), **Plus** 2–3 s an die Litze
   einer Etage (gelb / grün / blau).
3. Erwartung: nur `<Etage> gedrückt` geht auf **ON**, ein Event `gedrueckt` erscheint; nach dem Trennen ~200 ms später **OFF**.

Ergebnis 11.10.: blau → nur „Etage 2“, gelb → nur „Erdgeschoss“, grün → nur „Etage 1“, je mehrfach, jedes Mal Event
`gedrueckt`, **kein Übersprechen**. Auffällig: Das Event kam im Log erst nach dem OFF an – ungeklärt, siehe
[fehlersuche.md Nr. 16](fehlersuche.md#16-event-erscheint-erst-nach-dem-off).

> **Kein 18650-Shield (Powerbank-Platine) als Quelle:** Damit gab es **keine** Erkennung – vermutlich schaltet das
> Shield bei ~8 mA Last seinen Ausgang nicht ein (nicht weiter untersucht). Eine Batterie direkt oder ein Labornetzteil
> nehmen.

### Ursprünglicher Vorschlag (nicht verwendet)

Vom **5V-Pin** des D1 mini über den bestückten 1 kΩ an **Pin 1**, Pin-2-Schiene an **G**; Strom dabei
(5 − 1,2) V / 1 kΩ ≈ 3,8 mA. Nicht genutzt, weil G belegt ist und die Trennung der Seiten dafür aufgehoben werden müsste.

Damit ist die Ausgangsseite geprüft. Das **Wechselspannungsverhalten** (50 Pulse/s) prüft erst der Test an der Anlage.

---

## 6. Filter am echten Signal kontrollieren

Konfiguration (seit 11.10.): `delayed_off: 200ms`, **dann** `delayed_on: 230ms`.

| Situation | Erwartung |
|---|---|
| kurzer Druck (~0,3 s) | genau **ein** Event; Eingang meldet sich nach ~0,23 s und bleibt ~0,2 s länger an als gedrückt |
| langer Druck (3 s) | ein Event, kein Flackern ON/OFF im Log |
| zweimal kurz hintereinander (< 0,2 s Pause) | ein Event (Pause wird überbrückt) |
| kein Druck, Gong ruhig | keine Events (Störspitzen < 30 ms werden verworfen) |

**Behoben am 11.10. (vor dem Erstflash):** ESPHome wendet die Filter **der Reihe nach** an. Mit PC817 + Gegendiode ist
der Eingang pro 20-ms-Periode nur rund 8–10 ms „an“. Die frühere Konfiguration hatte `delayed_on: 30ms` als **ersten**
Filter – der verwirft ein ON, sobald vor Ablauf der 30 ms ein OFF kommt, und das passiert bei Halbwellen jede Periode.
Dann wäre **gar kein** Druck durchgekommen. Jetzt glättet `delayed_off: 200ms` zuerst; `delayed_on` steht auf 230 ms
(200 + 30), weil `delayed_off` auch Störspitzen um 200 ms verlängert – so bleiben Spitzen < 30 ms verworfen. Beim
Tischtest mit Gleichspannung (Schritt 5) fällt die Reihenfolge **nicht** auf; am echten Signal ist sie noch nicht
beobachtet. Siehe [fehlersuche.md](fehlersuche.md#1-gong-klingelt-aber-kein-ereignis-in-ha).

---

## 7. WLAN am Einbauort

Die Verteiler sind Kunststoff in einer Holznische (kein Metallkasten), ein normaler D1 mini sollte reichen – laut
Notiz trotzdem **nach dem Einbau prüfen**: Entität `WLAN-Signal` (alle 120 s).

| RSSI | Bewertung *(allgemeiner Richtwert, nicht aus den Notizen)* |
|---|---|
| besser als −70 dBm | gut |
| −70 … −80 dBm | brauchbar, Events können sich verzögern |
| schlechter als −80 dBm | Abhilfe: Lage ändern; notfalls D1 mini Pro mit Außenantenne |

---

## 8. Sperrzeit in Home Assistant

Die Automation meldet je Taster höchstens alle **15 s**. Getestet (04.10., Template in HA):

| Vorher → nachher | Abstand | Ergebnis |
|---|---|---|
| `unknown` → Zeitstempel | erster Druck überhaupt | meldet |
| Zeitstempel → Zeitstempel | 8 s | meldet **nicht** |
| Zeitstempel → Zeitstempel | 20 s | meldet |

Die Sperre ist **je Etage** getrennt – zwei Etagen kurz nacheinander melden beide.
