Sparxx947/esphome-klingel/plaene/klingel-schaltplan-mosfet.pdf

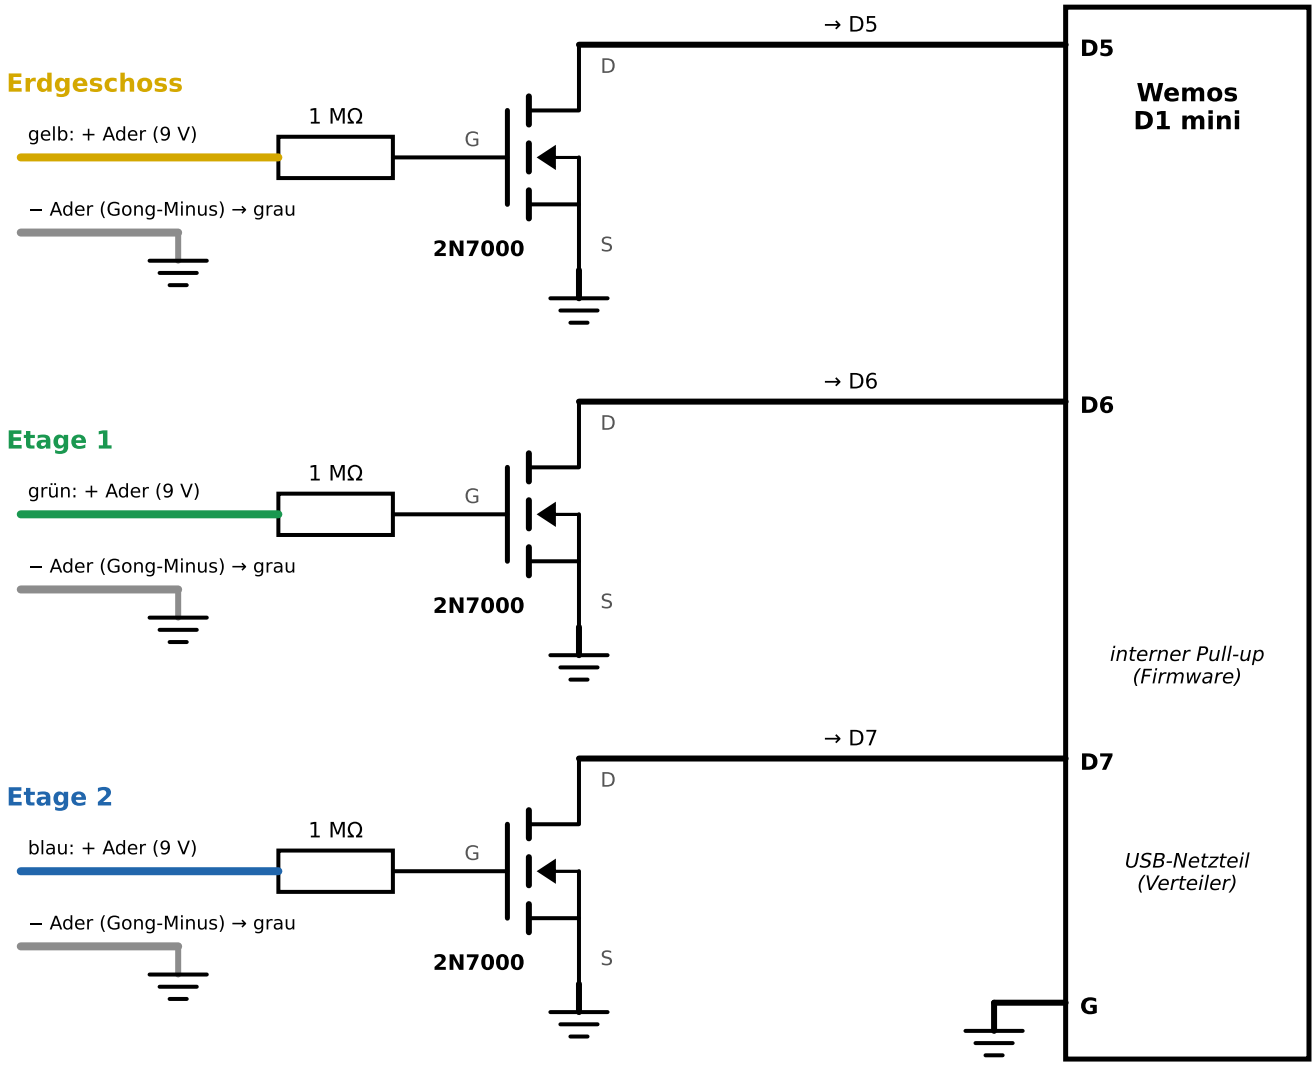
[picture p1: figure]
Erdgeschoss; gelb: + Ader (9 V); Ader (Gong-Minus); grau; Etage 1; grün: + Ader (9 V); Etage 2; blau: + Ader (9 V); Wemos D1 mini; interner Pull-up (Firmware); USB-Netzteil (Verteiler)

Massezeichen = gemeinsame Masse: alle Source-Beinchen + alle Minus-Adern (grau) + D1 G (schwarz)

# Türklingel Home Assistant: Umbau auf 2N7000 (Batteriegong mit Kontakteingang)

3 × 2N7000 + 3 × 1 M , Wemos D1 mini · Stand 12.10.2026 · Optokoppler, 1N4007 und 1 k entfallen · Trafo ist NICHT beteiligt

## VOR dem Löten messen (DC)

Je Etage die 2 Adern mit 9 V finden.

Schwarz an Ader A, rot an Ader B:

+9 V | B ist Plus (Signal), A ist Minus
9 V | umgekehrt

Plan gilt nur, wenn je Etage eine eigene

Plus-Ader und Minus gemeinsam/verbindbar.

Sonst: Werte an Claude, Plan anpassen.

## Pinbelegung 2N7000

2N7000
(flache Seite)
S | G | D
links | rechts:
Source · Gate · Drain

Gegenprobe Diodentest: rot an S, schwarz an D

0,5 0,8 V (Body-Diode), umgekehrt: OL

## Bauteile

1 M : braun | schwarz | grün ( gold)
oder braun | schwarz | schwarz | gelb braun

Raus: 3× PC817, 3× 1N4007, 3× 1 k

## Funktion

Ruhe: Ader 9 V | MOSFET leitet | Dx = LOW
Taste: Ader 0 V | MOSFET sperrt | Dx = HIGH
Gong-Last: | 0 (Gate zieht keinen Strom)
Nie zwei Plus-Adern verbinden und nie Plus mit Minus | das ist für den Gong ein Tastendruck · Minus-Adern dürfen zusammen
Keine Pins D3/D4/D8 · nach dem Löten Durchgang prüfen: Drain | Gate und Drain | Source dürfen nicht piepen
