Sparxx947/esphome-klingel/plaene/klingel-platine-bc517-vorschau2.png

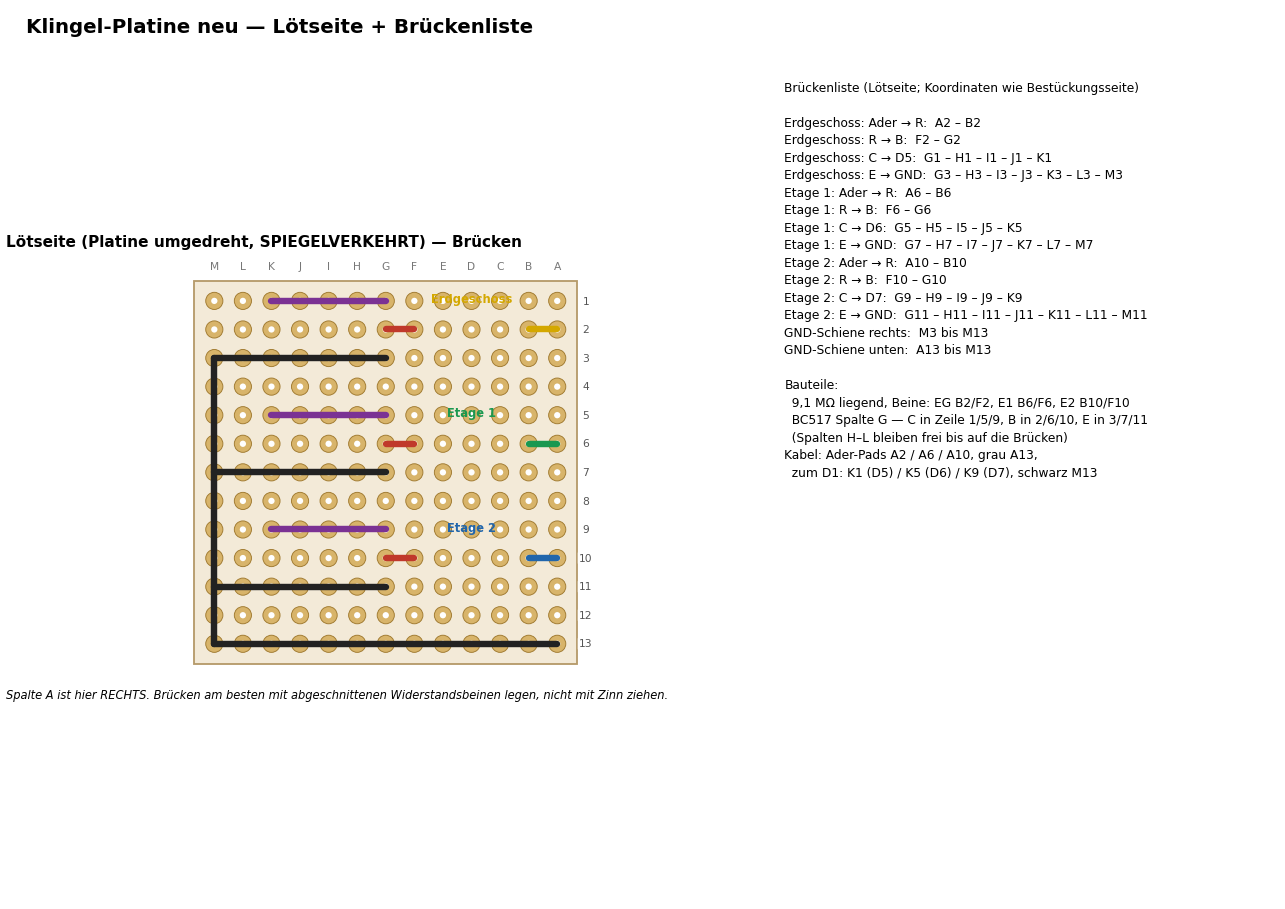
plaene/klingel-platine-bc517-vorschau2.png
