Sparxx947/esphome-klingel/plaene/klingel-schaltplan-mosfet-vorschau.png

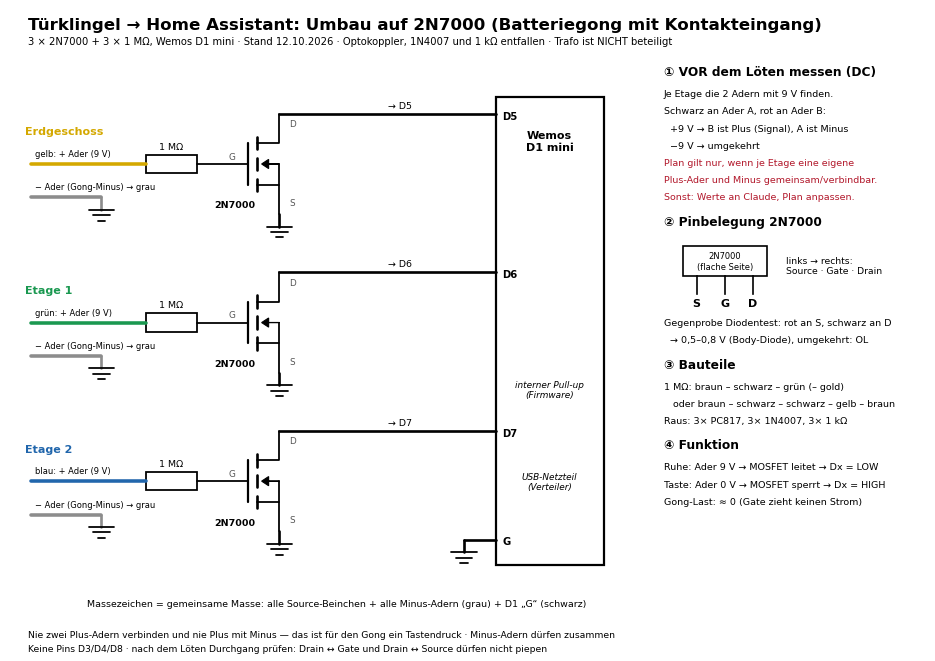
plaene/klingel-schaltplan-mosfet-vorschau.png
