Sparxx947/esphome-klingel/(commit log)

2026-10-08 Initial commit: firmware, plans, enclosures and documentation (DE/EN)
2026-10-09 Status: Lötplatinen geliefert, Adern-Messung auf 10.10. verschoben
    Teile komplett (PC817C, Dioden, Minilötplatinen). README DE/EN + Verlauf nachgezogen.
    Fixes #1
2026-10-11 Stand 11.10.2026: Erstflash, Tischtest, Gehäuse, farbiger Schaltplan
    - Firmware: Filter-Reihenfolge korrigiert (delayed_off 200ms vor
    delayed_on 230ms), Kopfkommentare auf PC817 + USB-Versorgung
    - gehaeuse/: OpenSCAD-Quelle, Box- und Deckel-STL
    - plaene/: farbiger Druckplan (PDF) + Erzeugerskript
    - Doku DE/EN: Platine gelötet (Einzelpad-Lehre, Messwerte),
    1 kΩ verbaut, Litzenfarben, Erstflash, Tischtest mit 18650-Zelle,
    Event-Auffälligkeit (offen), Gehäuse, Status und offene Punkte
2026-10-11 Docs: HA adoption done, event timing resolved, enclosure header
    All enclosure dimensions are measured; geometry unchanged.
    Fixes #5
2026-10-13 Stand 13.10.2026: Batteriegongs, PC817 ungeeignet, Umbau auf 2N7000 geplant
    Einbautest 12.10.: Jede Etage hat einen eigenen Batteriegong mit
    Kontakteingang, der Klingeltrafo ist nicht im Gong-Kreis - der
    PC817-Abgriff bekommt nie Strom. Dokumentiert in README und docs (DE/EN):
    Status, Verlauf 12./13.10., Mess-Lehre (Messbereich am bekannten Anker
    pruefen, Geraet am anderen Ende ansehen), Fehlersuche Nr. 19-22.
    Neu in plaene/: MOSFET-Plan (2N7000 + 1 MOhm) und Messblatt
    Abzweigdose samt Erzeugerskripten. Firmware noch unveraendert.
    Fixes #7
2026-10-20 Status 20.10.2026: BC517 build working, acceptance test passed
    - firmware: not inverted, 30/100 ms debounce, 'Klingelbatterie leer' sensor
    - plaene: BC517 board plan (+ BC547 Darlington substitute), measuring sheet, continuity check
    - README/docs DE+EN: BC517 circuit, status, history 14.-20.10., troubleshooting no. 23/24
    - PC817 and 2N7000 material marked as historical
    Fixes #9
2026-10-20 HA integration: push with camera image + live image on the floor's wall panel
    - ha/klingel-automation.yaml, ha/klingel-kamera-skript.yaml, ha/klingel-kamera-dashboard.yaml (anonymised, placeholders)
    - old package draft moved to ha/historisch/ (never created in HA)
    - docs/home-assistant.md/.en.md: flow, rebuilding, acceptance 20.10. 17:03, pitfalls
    - README, einbau, verlauf, fehlersuche (DE/EN) updated; extra ring on 20.10. was a real visitor
    Fixes #11
